HexabitzPlatform/P08R6x-Hardware/README.md

# P08R6x-Hardware
Hexabitz VL53L8 Time-of-Flight IR Sensor Module Hardware Design
