HexabitzPlatform/P08R6x-Hardware/Documentation/P08R6 Schematics.pdf

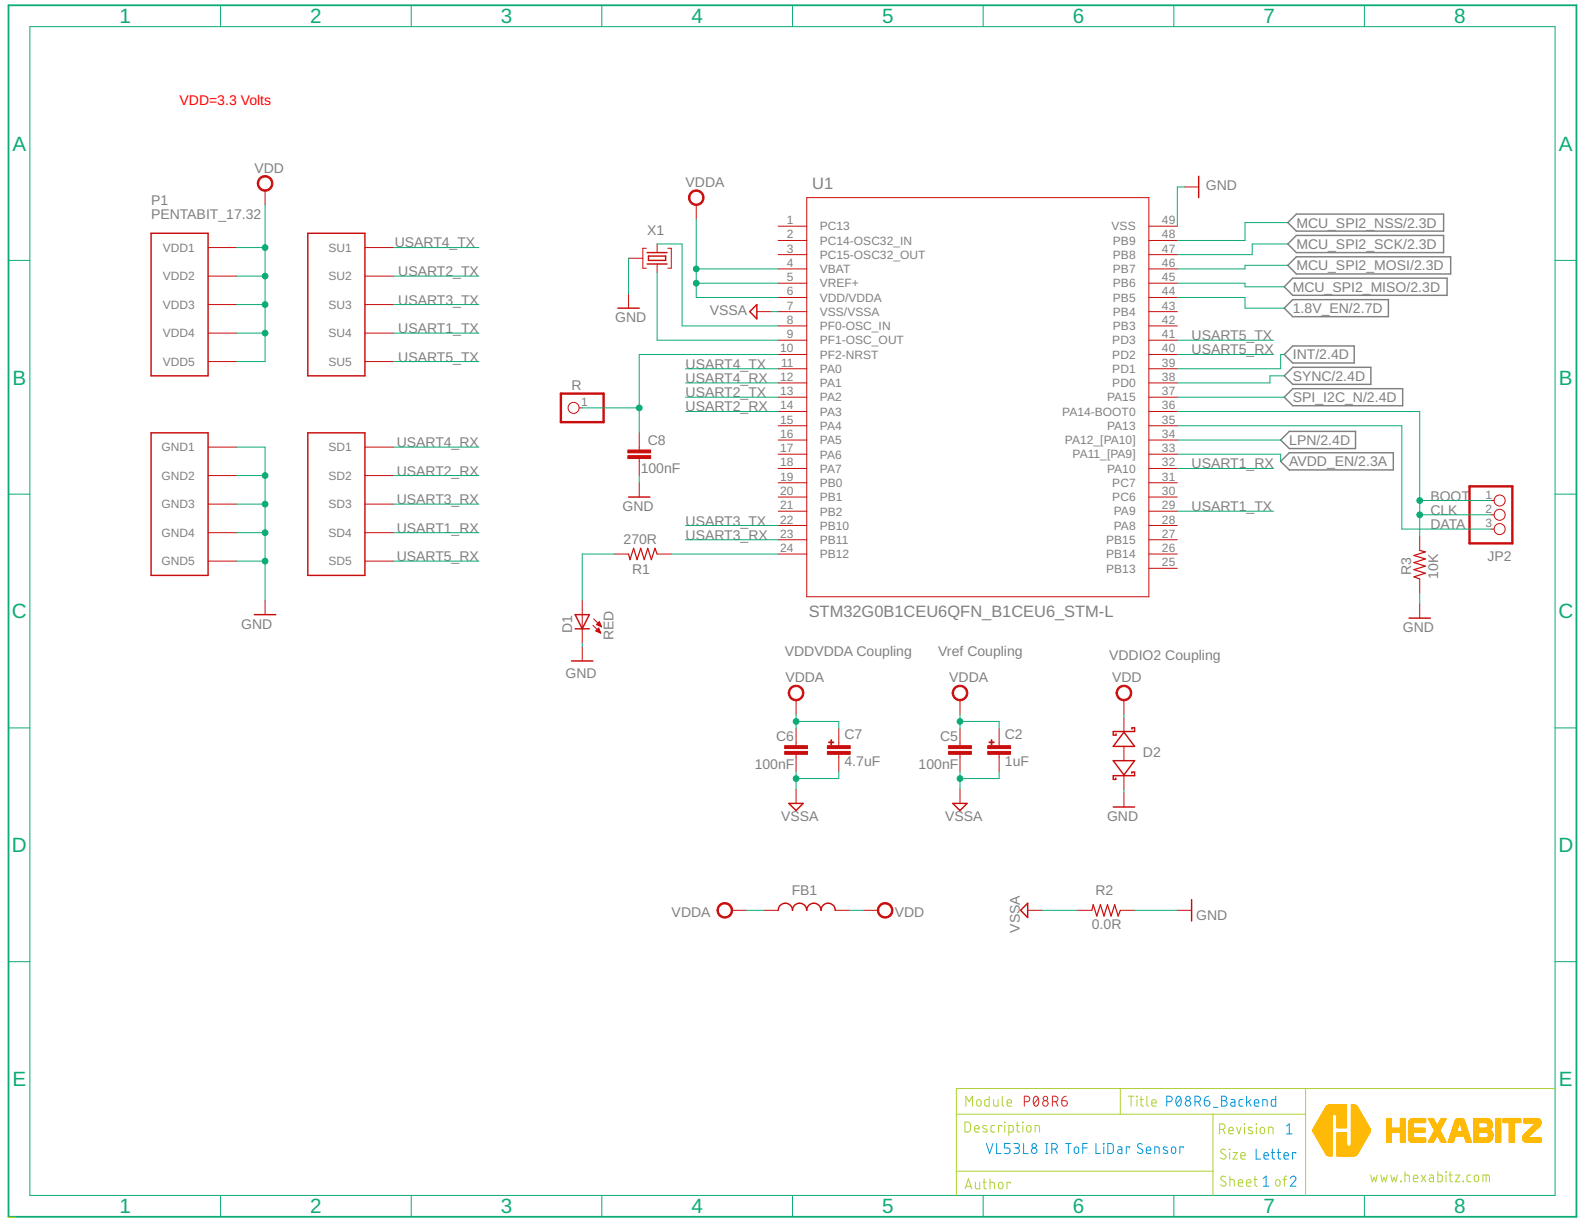
[picture p1: page 1]

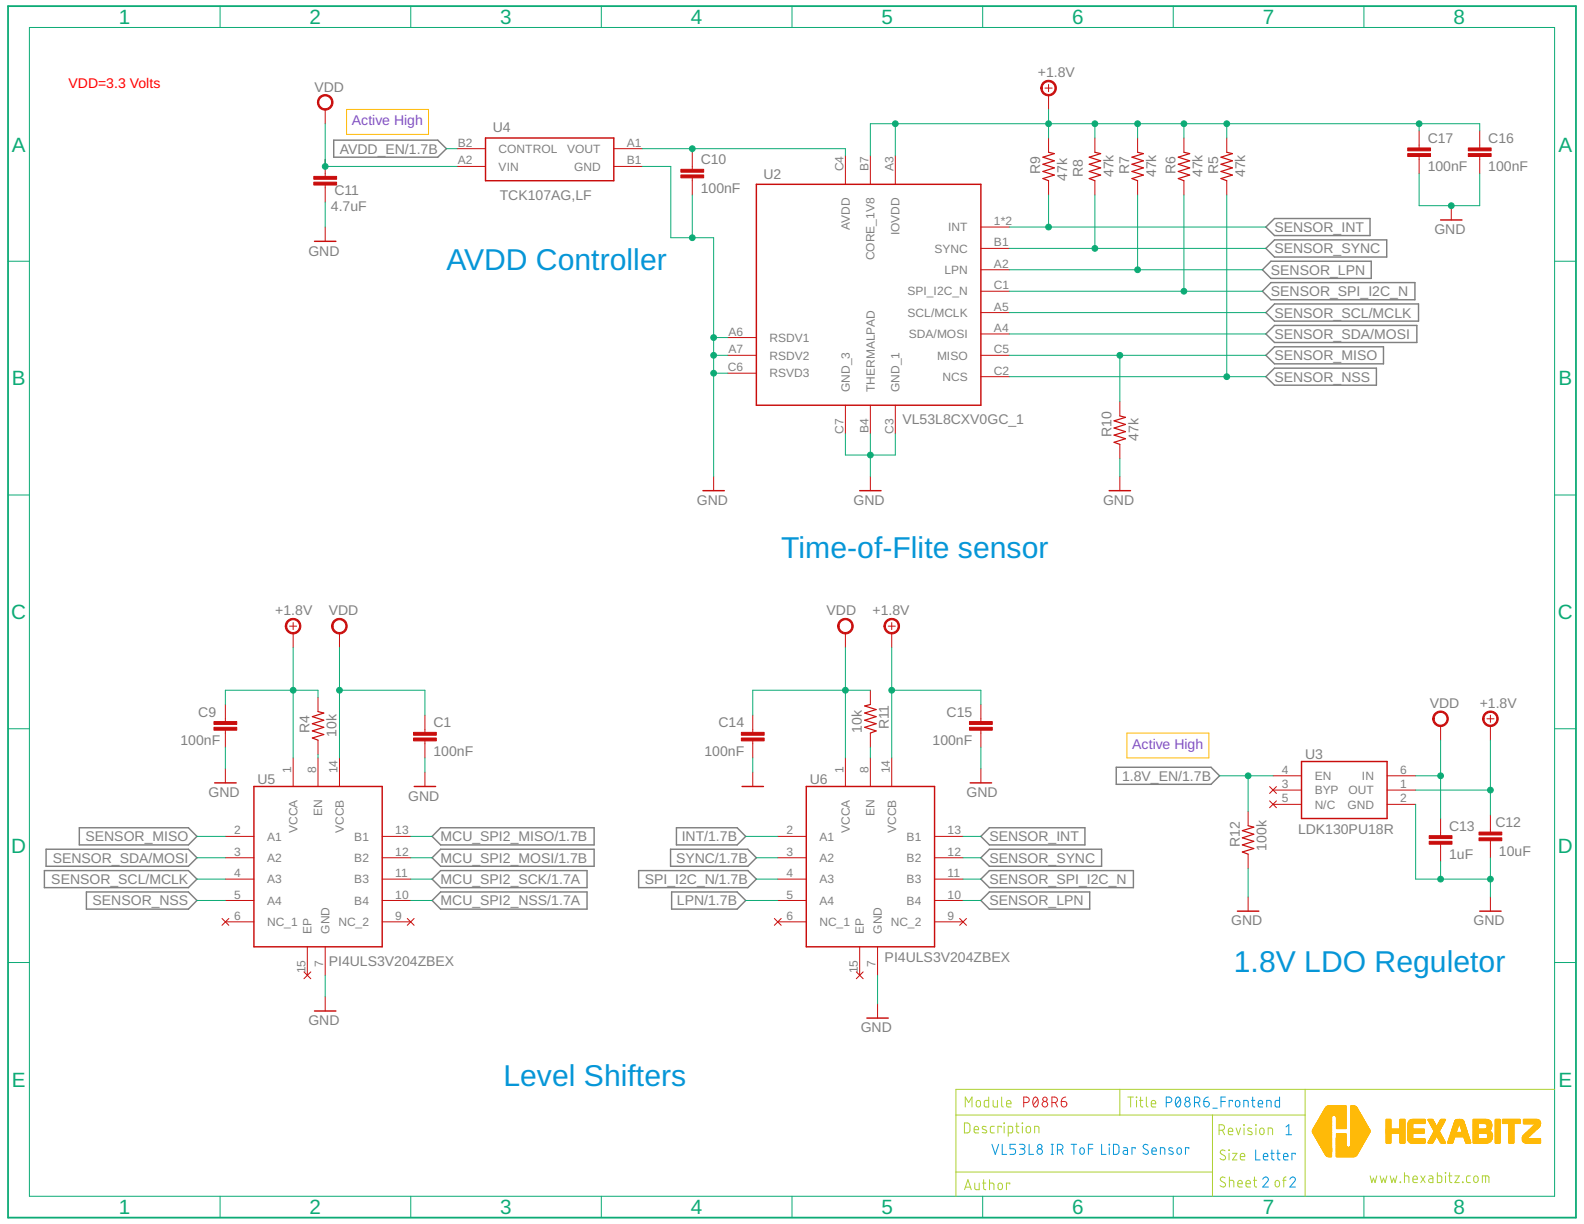
[picture p2: page 2]

A3 SDA/MOSI A4 SCL/MCLK

Time-of-Flite sensor

SYNC/1.7B | SENSOR_SYNC
SPI_I2C_N/1.7B | SENSOR_SPI_I2C_N
