HexabitzPlatform/P08R6x-Hardware/Design/P08R6.brd

## EAGLE design Design/P08R6.brd (2024-12-11)

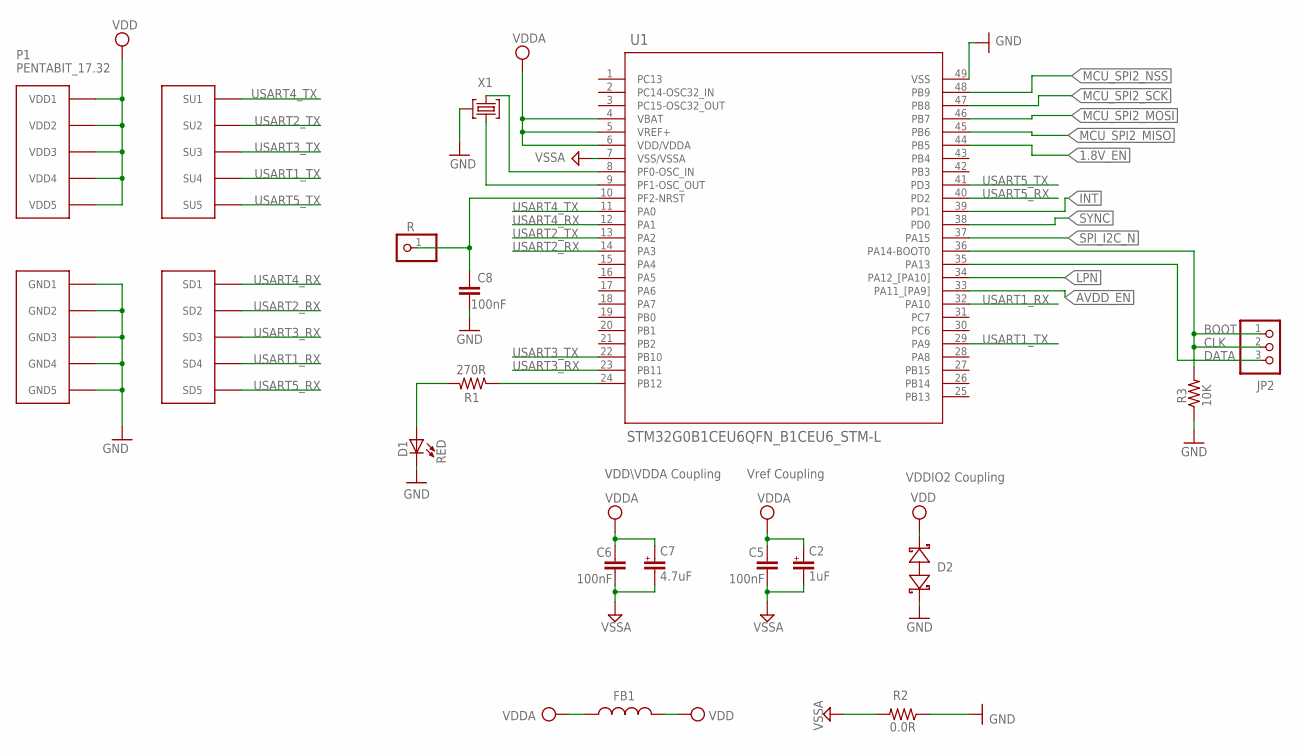
[picture p3: schematic P08R6.sch, sheet 1]

Parts:
C2: 1uF; C-0603-POL
C5, C6, C8: 100nF; C-0402
C7: 4.7uF; C-0603-POL
D1: RED; VLMS1300-GS08; MPN VLMS1300-GS08
D2: BOURNS_CDSOD323-T03SCBOURNS_CDSOD323-T03SC_0_0; BOURNS_CDSOD323-T03SC_0
FB1: FB-TDK_MMZ1608Y300B; FB-0603; MPN MMZ1608Y300B
JP2: PINHD-1X3; 1X03
P1: PENTABIT_17.32
R: R; 1X01
R1: 270R; R-0402
R2: 0.0R; R-0402; MPN RC0603JR-070RL
R3: 10K; R-0402
TRIMBLE-LOGO1: HEXA-LOGO
U1: STM32G0B1CEU6QFN_B1CEU6_STM-L; QFN_B1CEU6_STM-L
X1: XTALL_CSTCE8M00G52

Connections:
1.8V_EN: U1.44 (PB5); also elsewhere on the board
AVDD_EN: U1.33 (PA11_[PA9]); also elsewhere on the board
CLK: JP2.1, JP2.2, R3.2, U1.36 (PA14-BOOT0)
DATA: JP2.3, U1.35 (PA13)
GND: C8.2, D1.C, D2.2 (C), P1.PAD_PD6 (GND1), P1.PAD_PD7 (GND2), P1.PAD_PD8 (GND3), P1.PAD_PD9 (GND4), P1.PAD_PD10 (GND5), R2.1, R3.1, U1.49 (VSS), X1.P$2 (2); also elsewhere on the board
INT: U1.39 (PD1); also elsewhere on the board
LPN: U1.34 (PA12_[PA10]); also elsewhere on the board
MCU_SPI2_MISO: U1.45 (PB6); also elsewhere on the board
MCU_SPI2_MOSI: U1.46 (PB7); also elsewhere on the board
MCU_SPI2_NSS: U1.48 (PB9); also elsewhere on the board
MCU_SPI2_SCK: U1.47 (PB8); also elsewhere on the board
unnamed: D1.A, R1.2
unnamed: C8.1, R.1, U1.10 (PF2-NRST)
unnamed: U1.9 (PF1-OSC_OUT), X1.P$1 (1)
unnamed: U1.8 (PF0-OSC_IN), X1.P$3 (3)
unnamed: R1.1, U1.24 (PB12)
SPI_I2C_N: U1.37 (PA15); also elsewhere on the board
SYNC: U1.38 (PD0); also elsewhere on the board
USART1_RX: P1.PAD_PD4 (SD4), U1.32 (PA10)
USART1_TX: P1.PAD_PU4 (SU4), U1.29 (PA9)
USART2_RX: P1.PAD_PD2 (SD2), U1.14 (PA3)
USART2_TX: P1.PAD_PU2 (SU2), U1.13 (PA2)
USART3_RX: P1.PAD_PD3 (SD3), U1.23 (PB11)
USART3_TX: P1.PAD_PU3 (SU3), U1.22 (PB10)
USART4_RX: P1.PAD_PD1 (SD1), U1.12 (PA1)
USART4_TX: P1.PAD_PU1 (SU1), U1.11 (PA0)
USART5_RX: P1.PAD_PD5 (SD5), U1.40 (PD2)
USART5_TX: P1.PAD_PU5 (SU5), U1.41 (PD3)
VDD: D2.1 (A), FB1.2, P1.PAD_PU6 (VDD1), P1.PAD_PU7 (VDD2), P1.PAD_PU8 (VDD3), P1.PAD_PU9 (VDD4), P1.PAD_PU10 (VDD5); also elsewhere on the board
VDDA: C2.1, C5.1, C6.1, C7.1, FB1.1, U1.4 (VBAT), U1.5 (VREF+), U1.6 (VDD/VDDA)
VSSA: C2.2, C5.2, C6.2, C7.2, R2.2, U1.7 (VSS/VSSA)

Notes on the sheet:
Vref Coupling
VDDIO2 Coupling
VDD\VDDA Coupling
BOOT

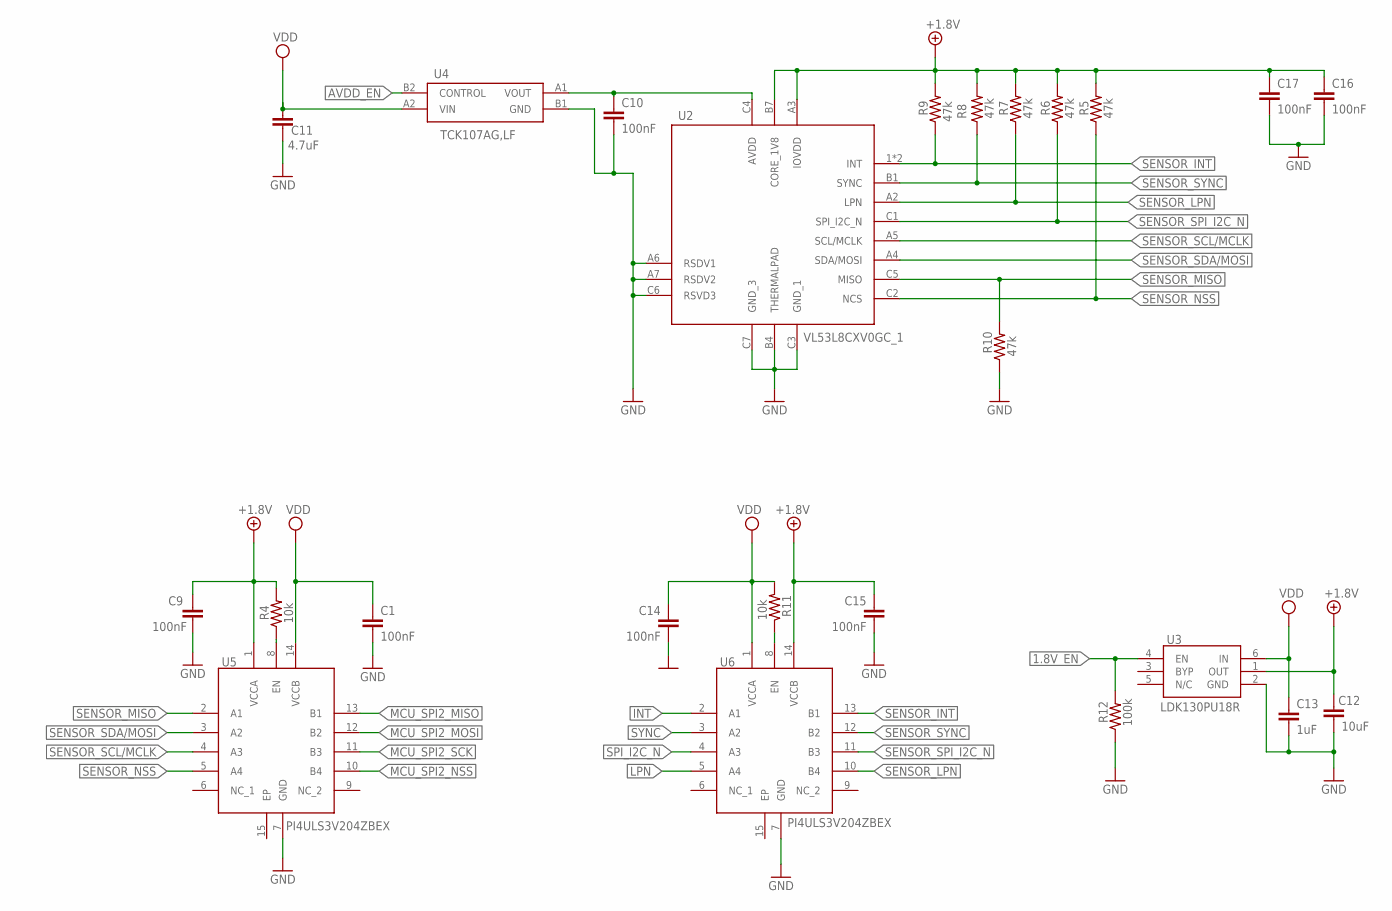
[picture p4: schematic P08R6.sch, sheet 2]

Parts:
C1, C9, C10, C14, C15, C16, C17: 100nF; C-0402
C11: 4.7uF; C-0603
C12: 10uF; C-0402
C13: 1uF; C-0402
R4, R11: 10k; R-0402
R5, R6, R7, R8, R9, R10: 47k; R-0402
R12: 100k; R-0402
U2: VL53L8CXV0GC_1; VL53L8CXV0GC1
U3: LDK130PU18R
U4: TCK107AG,LF; BGA4C40P2X2_79X79X59
U5, U6: PI4ULS3V204ZBEX

Connections:
1.8V_EN: R12.2, U3.4 (EN); also elsewhere on the board
+1.8V: C9.1, C12.1, C15.1, C16.1, C17.1, R4.2, R5.2, R6.2, R7.2, R8.2, R9.2, U2.A3 (IOVDD), U2.B7 (CORE_1V8), U3.1 (OUT), U5.1 (VCCA), U6.14 (VCCB)
AVDD_EN: U4.B2 (CONTROL); also elsewhere on the board
CONTROLLED_AVDD: C10.1, U2.C4 (AVDD), U4.A1 (VOUT)
GND: C1.2, C9.2, C10.2, C11.2, C12.2, C13.2, C14.2, C15.2, C16.2, C17.2, R10.1, R12.1, U2.A6 (RSDV1), U2.A7 (RSDV2), U2.B4 (THERMALPAD), U2.C3 (GND_1), U2.C6 (RSVD3), U2.C7 (GND_3), U3.2 (GND), U4.B1 (GND), U5.7 (GND), U6.7 (GND); also elsewhere on the board
INT: U6.2 (A1); also elsewhere on the board
LPN: U6.5 (A4); also elsewhere on the board
MCU_SPI2_MISO: U5.13 (B1); also elsewhere on the board
MCU_SPI2_MOSI: U5.12 (B2); also elsewhere on the board
MCU_SPI2_NSS: U5.10 (B4); also elsewhere on the board
MCU_SPI2_SCK: U5.11 (B3); also elsewhere on the board
unnamed: R4.1, U5.8 (EN)
unnamed: R11.1, U6.8 (EN)
SENSOR_INT: R9.1, U2.1 (INT), U2.A1 (INT), U6.13 (B1)
SENSOR_LPN: R7.1, U2.A2 (LPN), U6.10 (B4)
SENSOR_MISO: R10.2, U2.C5 (MISO), U5.2 (A1)
SENSOR_NSS: R5.1, U2.C2 (NCS), U5.5 (A4)
SENSOR_SCL/MCLK: U2.A5 (SCL/MCLK), U5.4 (A3)
SENSOR_SDA/MOSI: U2.A4 (SDA/MOSI), U5.3 (A2)
SENSOR_SPI_I2C_N: R6.1, U2.C1 (SPI_I2C_N), U6.11 (B3)
SENSOR_SYNC: R8.1, U2.B1 (SYNC), U6.12 (B2)
SPI_I2C_N: U6.4 (A3); also elsewhere on the board
SYNC: U6.3 (A2); also elsewhere on the board
VDD: C1.1, C11.1, C13.1, C14.1, R11.2, U3.6 (IN), U4.A2 (VIN), U5.14 (VCCB), U6.1 (VCCA); also elsewhere on the board

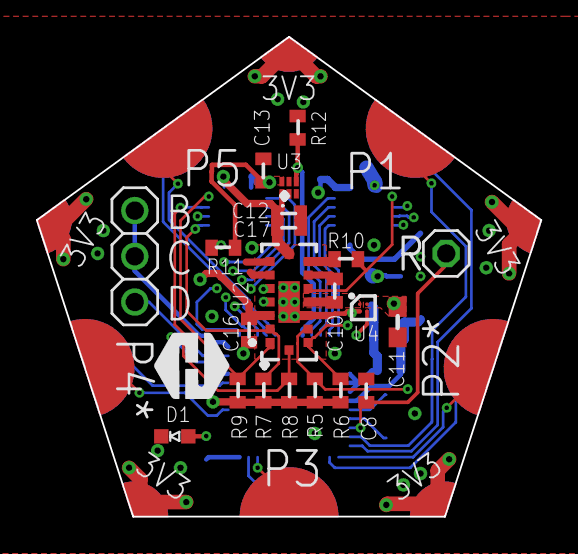
[picture p5: board P08R6.brd from above]

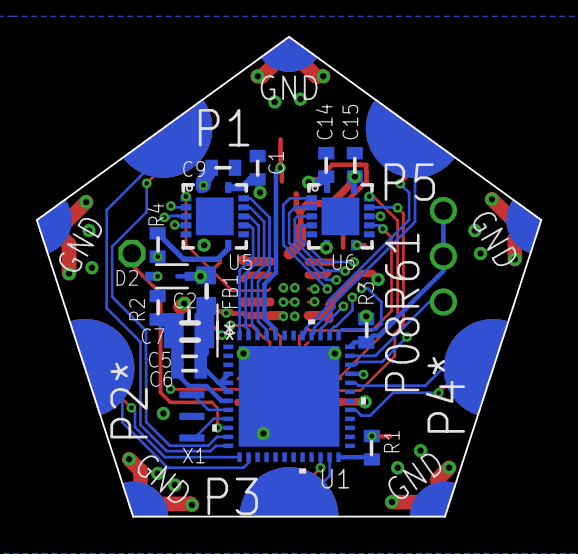
[picture p6: board P08R6.brd from below]

Board: 4 copper layers, 28.0 x 26.6 mm, 41 parts (18 on the bottom side), 43 nets.
