HexabitzPlatform/P08R6x-Hardware/(commit log)

2019-06-03 Port Schematics from H08 and route some signals
    [P08R60.brd, P08R60.sch]
2019-06-05 Module ready for Rev 0 release
    Finish routing the module
    Generate output files
    [P08R60.brd, P08R60.sch, P08R60.xlsx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]
2019-06-05 Adding git ignore
    Copying files into folder
    [P08R60.brd, P08R60.sch, P08R60.xlsx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]
2019-07-01 Fix R4 to R7 PN
    [P08R60.brd, P08R60.sch, P08R60.xlsx]
2019-08-09 Regenerate Schematics PDF file
    [P08R60.sch]
2024-12-11 -The final design, all done. -Upgrade the IR sensor and use VL53L8 - Changing the MCU to STM32G0.
2024-12-26 Add the TVS to the bom
    [P08R6.xlsx]
