HexabitzPlatform/P08R6x-Hardware/(notices)

Notices in the files:
parts and their libraries:
HEXABITZ_ICs: COPYRIGHT: Copyright (C) 2021 Ultra Librarian. All rights reserved.
